goldobot/Carte_pneumatique/Core/Src/main.c

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
/* Includes ------------------------------------------------------------------*/
#include "main.h"

/* USER CODE BEGIN Includes */
#include "dshot.h"
/* USER CODE END Includes */

/* USER CODE BEGIN PM */

//Partie moteurs (D-Shot)
#define CANONS_SPEED_1 100
#define CANONS_SPEED_2 300
#define CANONS_SPEED_3 400
#define TURBINE_SPEED_1 100
#define TURBINE_SPEED_2 300
#define TURBINE_SPEED_3 400
#define COMPRESSOR_SPEED 1200
//DSHOT_SPEED effet : change le bitrate du protocole D-Shot (jamais teste autre que 150=150kbits/s)
//autres valeurs existantes : 300, 600, 1200, voir Carte_pneumatique > TOOLS-DOCUMENTATION > DOC >
#define DSHOT_SPEED DSHOT150
//Compresseur : pour le Stop et le start
uint8_t COMPRESSOR_ENABLE = 0;

//Partie Pression
//size of pressure values history buffer : effet : change proportionnellement la rapidite de reponse du moteur du compresseur
#define PRESSURES_SIZE 10
// effet : change la pression de Commande initiale (avant 1ere commande compresseur)
uint8_t Press_order = 0; //en 10e de bar

//Partie electrovannes
#define PULSE_TIME 60 //valeur du pulse des EV (ms)
uint8_t last_EV_command = 0;

//Partie Capteur de Temperature
#define COMPR_CRIT_TEMP 60 //a modifier en fonction du systeme (position de la sonde PT100)
#define TEMPERATURES_SIZE 10

//Partie timer global pour tempo AU => purge
int BAU_tick;
uint8_t BAU_tick_enable = 0;

//Partie commandes et retours Rpi
//On teste un ring buffer
#define RING_BUF_SIZE 25
uint8_t r_buf_length;
uint8_t write_index;
uint8_t read_index;

uint8_t commands_buffer[RING_BUF_SIZE];

void write_r_buffer(uint8_t * r_buf, uint8_t command){
	if (r_buf_length == RING_BUF_SIZE){}
	else {
		r_buf[write_index] = command;
		write_index++;
		r_buf_length++;
	}
	if (write_index == RING_BUF_SIZE){
		write_index = 0;
	}
}

uint8_t read_r_buffer(uint8_t * r_buf){
	uint8_t val;
	if (r_buf_length == 0){return -1;}
	else {
		val = r_buf[read_index];
		read_index++;
		r_buf_length--;
	}
	if (read_index == RING_BUF_SIZE){
		read_index = 0;
	}
	return val;
}

uint8_t command_buffer = 0; // Signal commande Rpi -> Nucleo, pas de log pour l'instant donc taille de 1
uint8_t return_buffer[2]; //infos retournee Nucleo -> Rpi
HAL_StatusTypeDef res1;
HAL_StatusTypeDef res2;

/* USER CODE END PM */

ADC_HandleTypeDef hadc1;

CAN_HandleTypeDef hcan;

I2C_HandleTypeDef hi2c1;

TIM_HandleTypeDef htim1;
TIM_HandleTypeDef htim2;
TIM_HandleTypeDef htim3;
TIM_HandleTypeDef htim6;
DMA_HandleTypeDef hdma_tim1_ch1;
DMA_HandleTypeDef hdma_tim2_ch1;
DMA_HandleTypeDef hdma_tim2_ch3;
DMA_HandleTypeDef hdma_tim3_ch1_trig;
DMA_HandleTypeDef hdma_tim3_ch4_up;

UART_HandleTypeDef huart2;

void SystemClock_Config(void);
static void MX_GPIO_Init(void);
static void MX_DMA_Init(void);
static void MX_USART2_UART_Init(void);
static void MX_TIM2_Init(void);
static void MX_TIM6_Init(void);
static void MX_TIM3_Init(void);
static void MX_TIM1_Init(void);
static void MX_I2C1_Init(void);
static void MX_CAN_Init(void);
static void MX_ADC1_Init(void);
/* USER CODE BEGIN 0 */


//Partie D-Shot
uint16_t my_motor_value[5] = {0, 0, 0, 0, 0};

//Partie UART en interrupt
void HAL_UART_RxCpltCallback(UART_HandleTypeDef *huart)
{
	write_r_buffer(commands_buffer, command_buffer);
	res1=HAL_UART_Receive_IT(&huart2, &command_buffer, 1);
}


/* USER CODE END 0 */

/**
  * @brief  The application entry point.
  * @retval int
  */
int main(void)
{
  /* USER CODE BEGIN 1 */

	//Partie lecture des capteurs
	uint8_t I2C_buf[4]; //Infos I2C : P_sensor (4 bytes) ou T_sensor_Comp (?? bytes)
	// uint8_t p_buf[4]; //Pression P_sensor (2 bytes) et temperature P_sensor (2 bytes)
	//garder les logs des commandes

	//partie Capteur de Pression
	//modele : 2513130810401
	float pressure_val;
	//SENP:  Pressure sensor sensitivity : 4.196 ×10-2
	float SENP = 0.04196;
	//PMIN: Min Pressure output : -100 kPa
	int Pmin = -100;
	//OUTP_MIN: digital output at Pmin = 3277
	float OUT_Pmin = 3277;
	//P15bit = PH & PL
	float P15bit;
	//tableaux des 100 dernieres valeurs de pression, toutes les valeurs initialisees a 0
	uint8_t pressures[PRESSURES_SIZE] = {0};
	//valeur pour remplir le tableau des valeurs de pressions avant de calculer la moyennes des pressions
	uint32_t pressures_mean = 0;

	//Partie capteur de temperature du compresseur
	uint16_t raw;
	float compr_temp;
	uint8_t temperatures[TEMPERATURES_SIZE] = {0};
	uint8_t temperatures_mean = 0;

	// explication de la conversion des valeurs de l'ADC en temperature
	// dans le fichier "Equation_Sonde_PT100, il y a 2 courbes, ces coeffs sont respectivement les pentes et les ordonnees a l'origine
	// raw = valeur numerique renvoyee par l'ADC
	// methode de calibration sonde PT100 : mesure resistance et raw a 22°   &   mesure resistance et raw a 100° (pistolet a air chaud devant la PT100)
	float raw_to_res_mult = 0.0393;
	float raw_to_res_offset = -2.47;
	float res_to_temp_mult = -0.74;
	float res_to_temp_offset = 104;

	//Partie Arrêt d'urgence
	uint8_t AU_Current_Status = GPIO_PIN_RESET;
	uint8_t AU_Old_Status = GPIO_PIN_RESET;


  /* USER CODE END 1 */

  /* MCU Configuration--------------------------------------------------------*/

  /* Reset of all peripherals, Initializes the Flash interface and the Systick. */
  HAL_Init();

  /* Configure the system clock */
  SystemClock_Config();

  /* Initialize all configured peripherals */
  MX_GPIO_Init();
  MX_DMA_Init();
  MX_USART2_UART_Init();
  MX_TIM2_Init();
  MX_TIM6_Init();
  MX_TIM3_Init();
  MX_TIM1_Init();
  MX_I2C1_Init();
  MX_CAN_Init();
  MX_ADC1_Init();
  /* USER CODE BEGIN 2 */

	dshot_init(DSHOT_SPEED);
	//Initialization Des ESC des moteurs ET TOUT LE RESTE
	my_motor_value[0] = 0;
	my_motor_value[1] = 0;
	my_motor_value[2] = 0;
	my_motor_value[3] = 0;
	my_motor_value[4] = 0;
	HAL_GPIO_WritePin(GPIOA, GPIO_PIN_7, GPIO_PIN_RESET);
	HAL_GPIO_WritePin(GPIOA, GPIO_PIN_4, GPIO_PIN_RESET);
	HAL_GPIO_WritePin(GPIOA, GPIO_PIN_3, GPIO_PIN_RESET);
	HAL_GPIO_WritePin(GPIOF, GPIO_PIN_0, GPIO_PIN_RESET);
	//start to count (for tim6 interruption)
	HAL_TIM_Base_Start_IT(&htim6);
	//a peu pres temps minimal de delay pour laisser le temps aux moteurs de s'initialiser
	HAL_Delay(2600);
	//On lance l'interruption sur l'UART2, a relancer dans le callback !
	res1=HAL_UART_Receive_IT(&huart2, &command_buffer, 1);


  /* USER CODE END 2 */

  /* Infinite loop */
  /* USER CODE BEGIN WHILE */
	while (1)
	{
		//Partie AU : recuperation du state de l'AU
		AU_Current_Status = HAL_GPIO_ReadPin(GPIOF, GPIO_PIN_1);

		//res1=HAL_UART_Receive(&huart2, &command_buffer, 1, 100);

		//Partie Reset_small : Reset de tout lorsque l'AU repasse a l'etat haut (non coupe) alors qu'il etait a l'etat bas (coupe) juste avant
		if ((AU_Current_Status == GPIO_PIN_RESET) && AU_Old_Status == GPIO_PIN_SET){
			// arrêt moteurs (compr, canons, turbine)
			my_motor_value[0] = 0;
			my_motor_value[1] = 0;
			my_motor_value[2] = 0;
			my_motor_value[3] = 0;
			my_motor_value[4] = 0;
			HAL_Delay(2600);
			// arrêt EV 1, 2, 3 et Purge
			HAL_GPIO_WritePin(GPIOA, GPIO_PIN_7, GPIO_PIN_RESET);
			HAL_GPIO_WritePin(GPIOA, GPIO_PIN_4, GPIO_PIN_RESET);
			HAL_GPIO_WritePin(GPIOA, GPIO_PIN_3, GPIO_PIN_RESET);
			HAL_GPIO_WritePin(GPIOF, GPIO_PIN_0, GPIO_PIN_RESET);
			// arrêt LCD et LED Enable
			//HAL_GPIO_WritePin(GPIOB, GPIO_PIN_5, GPIO_PIN_RESET); commente car LCD pulse, a voir si c'est la source du probleme
			//HAL_GPIO_WritePin(GPIOB, GPIO_PIN_4, GPIO_PIN_RESET); commente car LED pulsent, a voir si c'est la source du probeme
			// reset la regulation de pression
			Press_order = 0;
			//reset le timer de purge
			BAU_tick = 0;
			BAU_tick_enable = 0;
		}

		//Partie Reset_Full : Si l'AU passe a l'etat bas (coupe) alors qu'il etait a l'etat haut (non coupe), reset tout et lancer un timer de 2 minutes, au bout duquel on purge !
		if (AU_Current_Status == GPIO_PIN_SET && AU_Old_Status == GPIO_PIN_RESET){
			// arrêt moteurs (compr, canons, turbine)
			my_motor_value[0] = 0;
			my_motor_value[1] = 0;
			my_motor_value[2] = 0;
			my_motor_value[3] = 0;
			my_motor_value[4] = 0;
			// arrêt EV 1, 2, 3 et Purge
			HAL_GPIO_WritePin(GPIOA, GPIO_PIN_7, GPIO_PIN_RESET);
			HAL_GPIO_WritePin(GPIOA, GPIO_PIN_4, GPIO_PIN_RESET);
			HAL_GPIO_WritePin(GPIOA, GPIO_PIN_3, GPIO_PIN_RESET);
			HAL_GPIO_WritePin(GPIOF, GPIO_PIN_0, GPIO_PIN_RESET);
			// arrêt LCD et LED Enable
			HAL_GPIO_WritePin(GPIOB, GPIO_PIN_5, GPIO_PIN_RESET);
			HAL_GPIO_WritePin(GPIOB, GPIO_PIN_4, GPIO_PIN_RESET);
			// reset la regulation de pression
			Press_order = 0;
			// tempo de 2 min, puis purge
			BAU_tick_enable = 1;
		}
		//changer les valeurs des AU status
		AU_Old_Status = AU_Current_Status;

		//Lecture de la pression en I2C et activation OU NON du compresseur en fonction
		res2 = HAL_I2C_Master_Receive(&hi2c1, 0xf1, I2C_buf, 4, 200);
		if (res2 == HAL_OK){
			//Regulation Pression
			//Calcul de la pression en 10emes de bar RELATIFS
			//voir infos_pressure_sensor plus haut pour infos sur variables
			P15bit = (int)((I2C_buf[0] << 8)|I2C_buf[1]);
			//formule d'apres la datasheet du capteur : pressure_val = [(P15bit - OUTP_MIN)*SENP)] + PMIN;
			//Conversion en 10emes de bar a la fin
			pressure_val = P15bit - OUT_Pmin; //2383
			pressure_val = pressure_val*SENP; //99.99068
			pressure_val = pressure_val + Pmin; // -0,00932
			pressure_val = pressure_val * 0.1; // -0,000932

			//calcul de la moyenne de toutes les pressions precedentes
			//on decale tout le tableau vers la droite, en faisant donc disparaître la valeur la plus ancienne
			for (int i = PRESSURES_SIZE-1; i > 0; i--){
				pressures[i] = pressures[i-1];
			}
			//On ajoute la nouvelle valeure
			pressures[0] = (int)pressure_val;

			//puis on fait la moyenne des pressions
			for (int i = 0; i < PRESSURES_SIZE; i++){
				pressures_mean+=pressures[i];
			}
			pressures_mean/=PRESSURES_SIZE;

			if (pressures_mean > (Press_order)){ // arrêter compresseur si depassement de la pression de consigne
				my_motor_value[4] = 0;
			}
			else if (pressures_mean < (Press_order - 2)) { // demarrage compresseur avec hysteresis de 0.2 bar
				if(Press_order >= 0 && COMPRESSOR_ENABLE){
					my_motor_value[4] = COMPRESSOR_SPEED;
				}
				else {}
			}
			else {}

			//on remet a 0 la moyenne des pressions
			pressures_mean = 0;
		}

		//Lecture Temperature du compresseur reservoir (sonde PT100) et activation ou desactivation du compresseur en fonction SSI il est pas deja desactive
		//start an ADC conversion
		HAL_ADC_Start(&hadc1);
		//processor waits for an ADC conversion to complete
		HAL_ADC_PollForConversion(&hadc1, HAL_MAX_DELAY);
		//get raw value from the ADC channel register
		raw = HAL_ADC_GetValue(&hadc1);

		//get temperature value from raw value (100-Ohm = 0°C, 375-Ohm = 800°C)
		//first : conversion from raw value to resistance value : 2790=>112 kOhm, 90=>6 kOhm
		//then : conversion from resistance value to temperature value :  112 kOhm=>22 °c, 6 kOhm=>100°c
		compr_temp = res_to_temp_mult * (raw_to_res_mult * raw + raw_to_res_offset) + res_to_temp_offset;

		//si Temperature critique, arrêter le compresseur et notifier la temperature critique dans le retour a la Rpi
		//on decale tout le tableau vers la droite, en faisant donc disparaître la valeur la plus ancienne
		for (int i = TEMPERATURES_SIZE-1; i > 0; i--){
			temperatures[i] = temperatures[i-1];
		}

		//On ajoute la nouvelle valeure
		temperatures[0] = compr_temp;

		//puis on fait la moyenne des pressions
		for (int i = 0; i < TEMPERATURES_SIZE; i++){
			temperatures_mean+=temperatures[i];
		}
		temperatures_mean /= TEMPERATURES_SIZE;

		//arrêt compresseur si depassement de la temperature critique
		if (temperatures_mean > COMPR_CRIT_TEMP) {
			my_motor_value[4] = 0;
			Press_order = 0;
		}

		//Notifier a la Rpi la bonne reception du mot de commande
		return_buffer[0]|= 1;
		//Retourner les infos a la Rpi !
		HAL_UART_Transmit(&huart2, return_buffer, 1, 100);
		uint8_t command = read_r_buffer(commands_buffer);
		if(command != -1){
			switch(command >> 6){
			case 0:
				//Mode 1 [00000001] : Reset nucleo: arrêt de TOUT
				if (command == 1){
					// arrêt moteurs (compr, canons, turbine)
					my_motor_value[0] = 0;
					my_motor_value[1] = 0;
					my_motor_value[2] = 0;
					my_motor_value[3] = 0;
					my_motor_value[4] = 0;
					// arrêt EV 1, 2, 3 et Purge
					HAL_GPIO_WritePin(GPIOA, GPIO_PIN_7, GPIO_PIN_RESET);
					HAL_GPIO_WritePin(GPIOA, GPIO_PIN_4, GPIO_PIN_RESET);
					HAL_GPIO_WritePin(GPIOA, GPIO_PIN_3, GPIO_PIN_RESET);
					HAL_GPIO_WritePin(GPIOF, GPIO_PIN_0, GPIO_PIN_SET);
					// arrêt LCD et LED Enable
					//HAL_GPIO_WritePin(GPIOB, GPIO_PIN_5, GPIO_PIN_RESET); commente car LCD pulsent, a voir si c'est la source du probleme
					//HAL_GPIO_WritePin(GPIOB, GPIO_PIN_4, GPIO_PIN_RESET); commente car LED pulsent, a voir si c'est la source du probleme
				}
				//Mode 2 [00000010] : Reset Moteurs
				else if (command == 2){
					my_motor_value[0] = 0;
					my_motor_value[1] = 0;
					my_motor_value[2] = 0;
					my_motor_value[3] = 0;
					my_motor_value[4] = 0;
					HAL_Delay(2600);
				}

				break;
			case 1:
				//Mode 2 [01]: Canons
				//ordre des canons : left=1 - right=2 - top=3
				//ecriture dans le moteur 1 (left)
				if ((command & 48) >> 4 == 0){
					my_motor_value[0] = 0;
				}
				else if ((command & 48) >> 4 == 1){
					my_motor_value[0] = CANONS_SPEED_1;
				}
				else if ((command & 48) >> 4 == 2){
					my_motor_value[0] = CANONS_SPEED_2;
				}
				else{
					my_motor_value[0] = CANONS_SPEED_3;
				}

				//ecriture dans le moteur 2 (right)
				if ((command & 12) >> 2 == 0){
					my_motor_value[1] = 0;
				}
				else if ((command & 12) >> 2 == 1){
					my_motor_value[1] = CANONS_SPEED_1;
				}
				else if ((command & 12) >> 2 == 2){
					my_motor_value[1] = CANONS_SPEED_2;
				}
				else{
					my_motor_value[1] = CANONS_SPEED_3;
				}

				//ecriture dans le moteur 3 (top)
				if ((command & 3) == 0){
					my_motor_value[2] = 0;
				}
				else if ((command & 3) == 1){
					my_motor_value[2] = CANONS_SPEED_1;
				}
				else if ((command & 3) == 2){
					my_motor_value[2] = CANONS_SPEED_2;
				}
				else{
					my_motor_value[2] = CANONS_SPEED_3;
				}


				break;
			case 2:
				//Mode 3 [10]: Compresseur / INIT
				//[10000001] : arrêt Compresseur + Consigne Pression => 0 + Purge EV4
				if ((command ^ 129) <= 1){
					my_motor_value[4] = 0;
					HAL_GPIO_WritePin(GPIOF, GPIO_PIN_0, command ^ 128);
					Press_order = 0;
					COMPRESSOR_ENABLE = 0;
				}
				else{
					//[10PPPPPP] : Val de consigne Pression, a recup SSI differente pour regulation au prochain tour de boucle
					Press_order = command ^ (2 << 6);
					COMPRESSOR_ENABLE = 1;
				}

				break;
			case 3:
				//Mode 4 [11]: electrovannes OU LED OU Turbine OU LCD
				//cas 1 : Electrovannes
				if ((command & 240) >> 4 == 12){
					//4*1 bits(ABCE) pour les EV (ordre du code : A: EV1<->PA7, B: EV2<->PA4, C: EV3<->PA3, E: EV_Purge<->PF0)
					HAL_GPIO_WritePin (GPIOA, GPIO_PIN_7, (command & 0x08) >> 3);
					HAL_GPIO_WritePin (GPIOA, GPIO_PIN_4, (command & 0x04) >> 2);
					HAL_GPIO_WritePin (GPIOA, GPIO_PIN_3, (command & 0x02) >> 1);
					HAL_GPIO_WritePin (GPIOF, GPIO_PIN_0, command & 0x01);
				}

				//cas 2 : EV-Pulse [1101000Z] => [0] : rien, [1] pulse ON-OFF-ON 1*, avec intervalle t-pulse_OFF
				if ((command & 240) >> 4 == 13){

					//Pulse EV 1
					if ((command & 8) >> 3 == 1 && HAL_GPIO_ReadPin(GPIOA, GPIO_PIN_7)){
						HAL_GPIO_WritePin(GPIOA, GPIO_PIN_7, GPIO_PIN_RESET);
						HAL_Delay(PULSE_TIME);
						HAL_GPIO_WritePin(GPIOA, GPIO_PIN_7, GPIO_PIN_SET);
					}
					//Pulse EV 2
					if ((command & 4) >> 2 == 1 && HAL_GPIO_ReadPin(GPIOA, GPIO_PIN_4)){
						HAL_GPIO_WritePin(GPIOA, GPIO_PIN_4, GPIO_PIN_RESET);
						HAL_Delay(PULSE_TIME);
						HAL_GPIO_WritePin(GPIOA, GPIO_PIN_4, GPIO_PIN_SET);
					}
					//Pulse EV 3
					if ((command & 2) >> 1 == 1 && HAL_GPIO_ReadPin(GPIOA, GPIO_PIN_3)){
						HAL_GPIO_WritePin(GPIOA, GPIO_PIN_3, GPIO_PIN_RESET);
						HAL_Delay(PULSE_TIME);
						HAL_GPIO_WritePin(GPIOA, GPIO_PIN_3, GPIO_PIN_SET);
					}
				}

				//cas 3 : Turbine [111000ZZ] (arrêt: [00], vitesse_1: [01], vitesse_2: [10], vitesse_3: [11])
				else if ((command & 240) >> 4 == 14){
					//ecriture valeurs dans moteur Turbine
					if ((command & 3) == 0){
						my_motor_value[3] = 0;
					}
					else if ((command & 3) == 1){
						my_motor_value[3] = TURBINE_SPEED_1;
					}
					else if ((command & 3) == 2){
						my_motor_value[3] = TURBINE_SPEED_2;
					}
					else{
						my_motor_value[3] = TURBINE_SPEED_3;
					}
				}

				//cas 4 : LCD/LED [111100YZ] => Y==0: LCD_reset/LED_reset, Z==1: LCD_set/LED_set
				else if ((command & 240) >> 4 == 15 && (command != 255)){
					//LCD
					if ((command & 2) >> 1 == 1) {
						HAL_GPIO_WritePin(GPIOB, GPIO_PIN_5, GPIO_PIN_SET);
					}
					else { HAL_GPIO_WritePin(GPIOB, GPIO_PIN_5, GPIO_PIN_RESET); }
					//HAL_GPIO_WritePin(GPIOB, GPIO_PIN_5, command & 2); commente car pas fou pareil que LED

					//LED
					if ((command & 1) == 1){
						HAL_GPIO_WritePin(GPIOB, GPIO_PIN_4, GPIO_PIN_SET);
					}
					else {
						HAL_GPIO_WritePin(GPIOB, GPIO_PIN_4, GPIO_PIN_RESET);
					}
					//HAL_GPIO_WritePin(GPIOB, GPIO_PIN_4, command & 1); commente car LED pulsent, a voir si c'est la source du probleme
				}
				break;
			}

		}

		HAL_Delay(1);


    /* USER CODE END WHILE */

    /* USER CODE BEGIN 3 */
	}
  /* USER CODE END 3 */
}

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
/* USER CODE BEGIN 4 */
void HAL_TIM_PeriodElapsedCallback(TIM_HandleTypeDef *htim)
{
	if (htim->Instance == htim6.Instance)
	{
		dshot_write(my_motor_value);
	}
	//on start la tempo si le BAU est enclenche
	if (BAU_tick_enable == 1){
		BAU_tick++;
		// on purge quand on veut purger, 1000 => 1s
		if (BAU_tick > 30000){
			BAU_tick = 0;
			BAU_tick_enable = 0;
			HAL_GPIO_WritePin(GPIOF, GPIO_PIN_0, GPIO_PIN_SET);
		}
	}
}
/* USER CODE END 4 */
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
