goldobot/Carte_pneumatique/Code_carte_pneumatique.ioc

Mcu.UserName=STM32F303K8Tx
PA0.GPIO_Label=ADC1_IN1_A_TEMP
PA0.Signal=ADC1_IN1
PA1.GPIO_Label=ADC2_IN_A_PRESS
PA1.Signal=ADC1_IN2
PA11.GPIO_Label=CAN_RD
PA11.Signal=CAN_RX
PA12.GPIO_Label=CAN_TD
PA12.Signal=CAN_TX
PA13.GPIO_Label=SWDIO
PA13.Signal=SYS_JTMS-SWDIO
PA14.GPIO_Label=SWCLK
PA14.Signal=SYS_JTCK-SWCLK
PA15.GPIO_Label=USART2_RX
PA15.Signal=USART2_RX
PA2.GPIO_Label=USART2_TX
PA2.Signal=USART2_TX
PA3.GPIO_Label=GPIO_Output_EV_3
PA3.Signal=GPIO_Output
PA4.GPIO_Label=GPIO_Output_EV_2
PA4.Signal=GPIO_Output
PA5.GPIO_Label=TIM2_CH1_DS_COMP
PA5.Signal=S_TIM2_CH1_ETR
PA6.GPIO_Label=TIM3_CH1_DS_TURB
PA6.Signal=S_TIM3_CH1
PA7.GPIO_Label=GPIO_Output_EV_1
PA7.Signal=GPIO_Output
PA8.GPIO_Label=TIM1_CH1_DS_M3
PA8.Signal=S_TIM1_CH1
PA9.GPIO_Label=TIM2_CH3_DS_M1
PA9.Signal=S_TIM2_CH3
PB1.GPIO_Label=TIM3_CH4_DS_M2
PB1.Signal=S_TIM3_CH4
PB3.GPIO_Label=Built_in_LED
PB3.Signal=GPIO_Output
PB4.GPIO_Label=GPIO_Output_LED_EN
PB4.Signal=GPIO_Output
PB5.GPIO_Label=GPIO_Output_LCD_EN
PB5.Signal=GPIO_Output
PB6.Signal=I2C1_SCL
PB7.Signal=I2C1_SDA
