goldobot/Carte_pneumatique/Core/Inc/main.h

#define GPIO_Output_EV_P_Pin GPIO_PIN_0
#define GPIO_Output_EV_P_GPIO_Port GPIOF
#define GPIO_Input_AU_STATUS_Pin GPIO_PIN_1
#define GPIO_Input_AU_STATUS_GPIO_Port GPIOF
#define ADC1_IN1_A_TEMP_Pin GPIO_PIN_0
#define ADC1_IN1_A_TEMP_GPIO_Port GPIOA
#define ADC2_IN_A_PRESS_Pin GPIO_PIN_1
#define ADC2_IN_A_PRESS_GPIO_Port GPIOA
#define USART2_TX_Pin GPIO_PIN_2
#define USART2_TX_GPIO_Port GPIOA
#define GPIO_Output_EV_3_Pin GPIO_PIN_3
#define GPIO_Output_EV_3_GPIO_Port GPIOA
#define GPIO_Output_EV_2_Pin GPIO_PIN_4
#define GPIO_Output_EV_2_GPIO_Port GPIOA
#define TIM2_CH1_DS_COMP_Pin GPIO_PIN_5
#define TIM2_CH1_DS_COMP_GPIO_Port GPIOA
#define TIM3_CH1_DS_TURB_Pin GPIO_PIN_6
#define TIM3_CH1_DS_TURB_GPIO_Port GPIOA
#define GPIO_Output_EV_1_Pin GPIO_PIN_7
#define GPIO_Output_EV_1_GPIO_Port GPIOA
#define TIM3_CH4_DS_M2_Pin GPIO_PIN_1
#define TIM3_CH4_DS_M2_GPIO_Port GPIOB
#define TIM1_CH1_DS_M3_Pin GPIO_PIN_8
#define TIM1_CH1_DS_M3_GPIO_Port GPIOA
#define TIM2_CH3_DS_M1_Pin GPIO_PIN_9
#define TIM2_CH3_DS_M1_GPIO_Port GPIOA
#define CAN_RD_Pin GPIO_PIN_11
#define CAN_RD_GPIO_Port GPIOA
#define CAN_TD_Pin GPIO_PIN_12
#define CAN_TD_GPIO_Port GPIOA
#define SWDIO_Pin GPIO_PIN_13
#define SWDIO_GPIO_Port GPIOA
#define SWCLK_Pin GPIO_PIN_14
#define SWCLK_GPIO_Port GPIOA
#define USART2_RX_Pin GPIO_PIN_15
#define USART2_RX_GPIO_Port GPIOA
#define Built_in_LED_Pin GPIO_PIN_3
#define Built_in_LED_GPIO_Port GPIOB
#define GPIO_Output_LED_EN_Pin GPIO_PIN_4
#define GPIO_Output_LED_EN_GPIO_Port GPIOB
#define GPIO_Output_LCD_EN_Pin GPIO_PIN_5
#define GPIO_Output_LCD_EN_GPIO_Port GPIOB
