goldobot/Carte_pneumatique/Core/Inc/dshot.h

/*
 * dshot.h
 *
 *  Created on: 2021. 1. 27.
 *      Author: mokhwasomssi
 */


#ifndef __DSHOT_H__
#define __DSHOT_H__


#include "main.h"    	// header from stm32cubemx code generate
#include <stdbool.h>
#include <math.h>		// lrintf


extern TIM_HandleTypeDef htim1;
extern TIM_HandleTypeDef htim2;
extern TIM_HandleTypeDef htim3;


/* User Configuration */
// Timer Clock
// FIXME : TODO : remove old value
//#define TIMER_CLOCK             8000000 // 8MHz
#define TIMER_CLOCK             24000000 // 24MHz

// MOTOR 1 (PA5) - TIM2 Channel 1, DMA1 Stream ?
#define MOTOR_1_TIM             (&htim2)
#define MOTOR_1_TIM_CHANNEL     TIM_CHANNEL_3
#define MOTOR_1_TIM_DMA_ID      TIM_DMA_ID_CC3
#define MOTOR_1_TIM_DMA         TIM_DMA_CC3
#define MOTOR_1_TIM_CCR         (MOTOR_1_TIM->Instance->CCR3)

// MOTOR 2 (PA9) - TIM2 Channel 3, DMA1 Stream ?
#define MOTOR_2_TIM             (&htim3)
#define MOTOR_2_TIM_CHANNEL     TIM_CHANNEL_4
#define MOTOR_2_TIM_DMA_ID      TIM_DMA_ID_CC4
#define MOTOR_2_TIM_DMA         TIM_DMA_CC4
#define MOTOR_2_TIM_CCR         (MOTOR_2_TIM->Instance->CCR4)

// MOTOR 3 (PA8) - TIM1 Channel 1, DMA1 Stream ?
#define MOTOR_3_TIM             (&htim1)
#define MOTOR_3_TIM_CHANNEL     TIM_CHANNEL_1
#define MOTOR_3_TIM_DMA_ID      TIM_DMA_ID_CC1
#define MOTOR_3_TIM_DMA         TIM_DMA_CC1
#define MOTOR_3_TIM_CCR         (MOTOR_3_TIM->Instance->CCR1)

// MOTOR 4 : TURBINE (PA6) - TIM3 Channel 1, DMA1 Stream ?
#define MOTOR_4_TIM             (&htim3)
#define MOTOR_4_TIM_CHANNEL     TIM_CHANNEL_1
#define MOTOR_4_TIM_DMA_ID      TIM_DMA_ID_CC1
#define MOTOR_4_TIM_DMA         TIM_DMA_CC1
#define MOTOR_4_TIM_CCR         (MOTOR_4_TIM->Instance->CCR1)

// MOTOR 5 : COMPRESSEUR (PA6) - TIM3 Channel 1, DMA1 Stream ?
#define MOTOR_5_TIM             (&htim2)
#define MOTOR_5_TIM_CHANNEL     TIM_CHANNEL_1
#define MOTOR_5_TIM_DMA_ID      TIM_DMA_ID_CC1
#define MOTOR_5_TIM_DMA         TIM_DMA_CC1
#define MOTOR_5_TIM_CCR         (MOTOR_5_TIM->Instance->CCR1)


/* Definition */
#define MHZ_TO_HZ(x) 			((x) * 1000000)

#define DSHOT600_HZ     		MHZ_TO_HZ(12)
#define DSHOT300_HZ     		MHZ_TO_HZ(6)
#define DSHOT150_HZ     		MHZ_TO_HZ(3)

#define MOTOR_BIT_0            	7
#define MOTOR_BIT_1            	14
#define MOTOR_BITLENGTH        	20

#define DSHOT_FRAME_SIZE       	16
#define DSHOT_DMA_BUFFER_SIZE   18 /* resolution + frame reset (2us) */

#define DSHOT_MIN_THROTTLE      48
#define DSHOT_MAX_THROTTLE     	2047
#define DSHOT_RANGE 			(DSHOT_MAX_THROTTLE - DSHOT_MIN_THROTTLE)


/* Enumeration */
typedef enum
{
    DSHOT150,
    DSHOT300,
    DSHOT600
} dshot_type_e;


/* Functions */
void dshot_init(dshot_type_e dshot_type);
void dshot_write(uint16_t* motor_value);


#endif /* __DSHOT_H__ */
