goldobot/Carte_pneumatique/(commit log)

2023-05-09 First commit !
    [Equation_Sonde_PT100.xlsx, conversion_data_PDUS.xlsx]
2023-05-13 2nd commit 13-05-23
    [Equation_Sonde_PT100.xlsx, conversion_data_PDUS.xlsx]
2023-05-14 compressor now doesn't start when Press_order is <= 0 Fix of EV (EV is no longer SET in the Dshot timer interrupt routine) Partial fix of the pulse
    [main.c, pneumatic.py]
2023-05-15 DEV :* Commande supplementaire permettant de reset les moteurs [00000001] * EV Pulse sont maintenant fonctionnels, on ne peut activer que une EV a la fois AUTRE : * Temperature compresseur est bonne 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
    [main.c, pneumatic.py]
2023-05-18 [DEV] * Ajout d u timer (a la zob) qui purge apres 120s apres push de l_AU (gere avec le meme timer que le D-shot: htim6) * set des EV a RESET en debut de code
    [Code_carte_pneumatique.ioc, main.c]
2023-06-10 essais de commit
2023-06-10 good, 50s timer working
2023-06-11 timer 50=>30+reset timer+retour [X0000000][X0000000] a rpi si command fail
    [main.c]
2023-06-12 - Reception des commandes Rpi en interrupt, yay
2023-06-18 fix FIFO liste chainee pour reception commandes Rpi
    [main.c]
2023-06-19 fix erreurs de code: init command_hist a NULL pour pas defiler a linfini dans le insert
    [main.c]
2023-06-23 clean du code et ajout temperature critique car elle etait commentee, ATTENTION PAS ENCORE TESTE SUR R2, prendre le commit precedent tant que pas teste
